LinBingKe/portable-soil-bulk-density-measuring-system/README.md

# portable-soil-bulk-density-measuring-system
Develop a portable soil bulk density measuring system for the fild measure immediately. The system composes of a 
soil bulk density sensor, a micro controller, and other components. The designed soil bulk density sensor collects 
the parameter with thermal theory. A micro controller combines with other components provides operation interface 
to collect, and upload data to cloud platform.
