LinBingKe/portable-soil-bulk-density-measuring-system/SystemHardware.pdf

# 可攜式總體密度量測系統

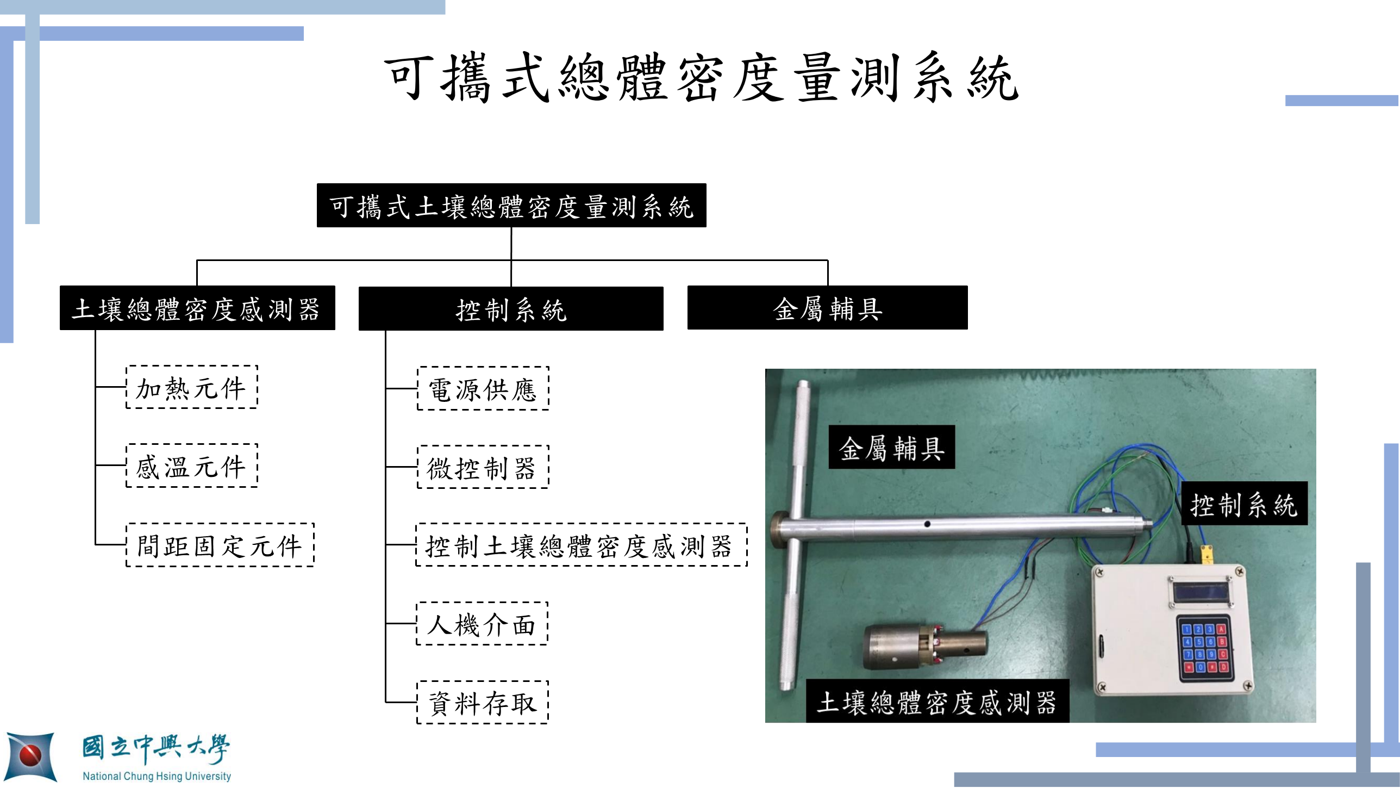
[picture p1: page 1]

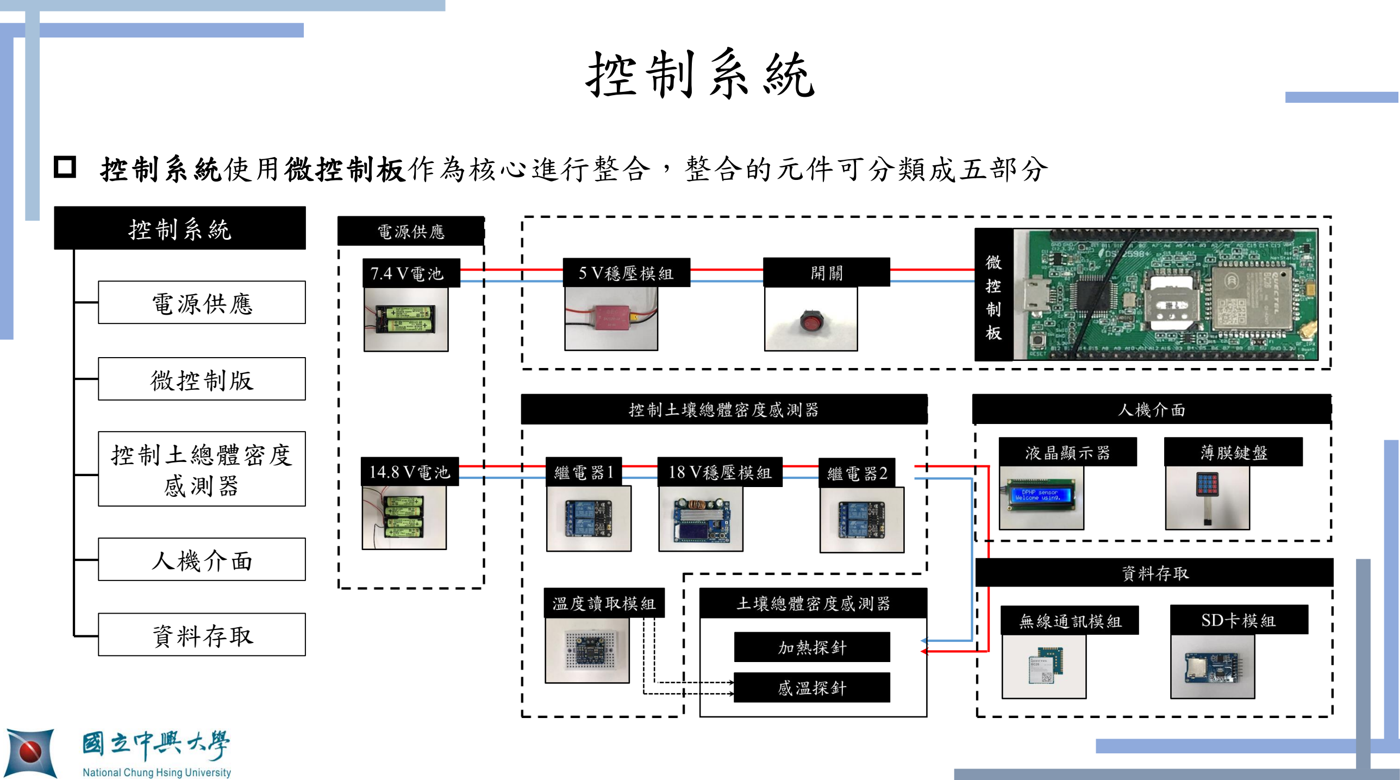
[picture p2: figure]
控制系統; 控制系統使用微控制板作為核心進行整合，整合的元件可分類成五部分; 電源供應; 微控制版; 控制土總體密度 感測器; 人機介面; 資料存取

# 硬體連接圖

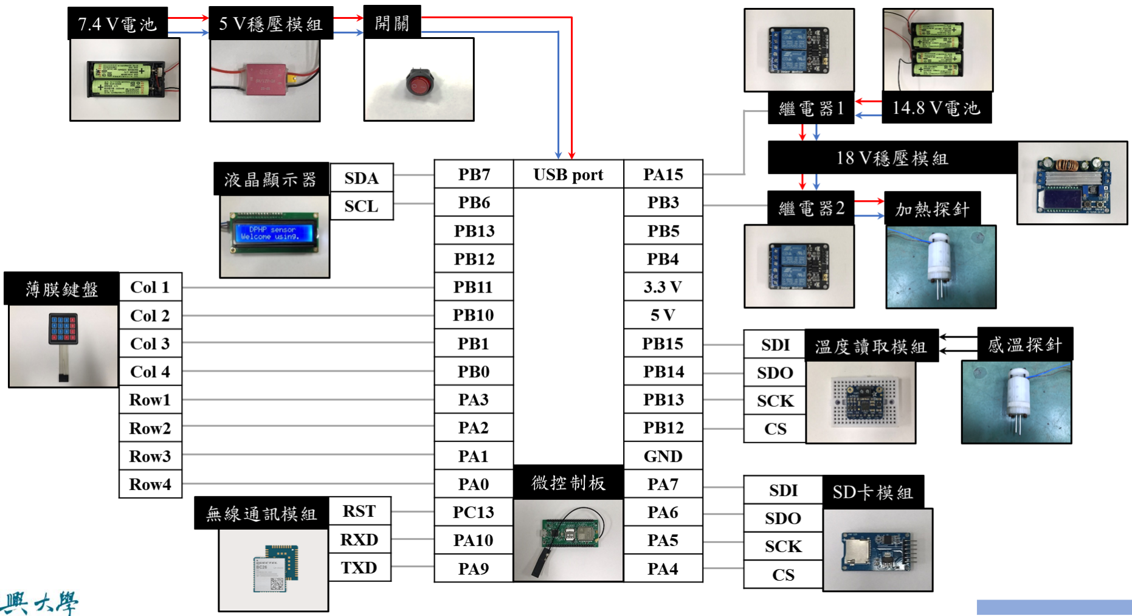
[picture p3: figure]

# 外部封裝殼

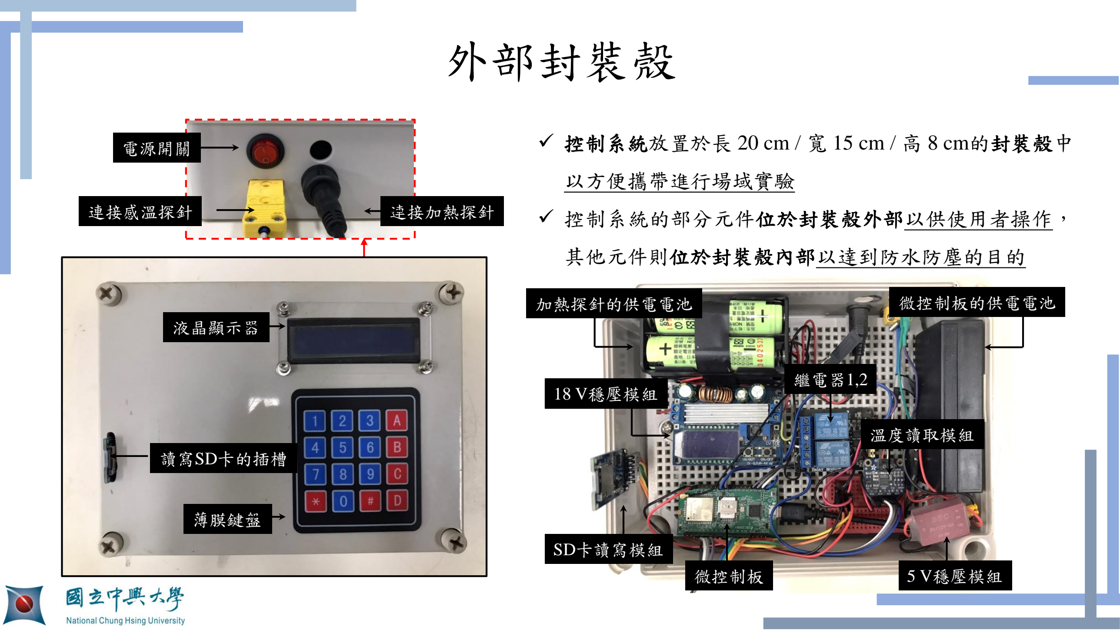
[picture p4: page 4]

加熱探針的供電電池 | 微控制板的供電電池
微控制板 | 5 V穩壓模組

18 V穩壓模組

✓ 控制系統放置於長 20 cm / 寬 15 cm / 高 8 cm的封裝殼中

以方便攜帶進行場域實驗

✓ 控制系統的部分元件位於封裝殼外部以供使用者操作，

其他元件則位於封裝殼內部以達到防水防塵的目的

連接感溫探針 | 連接加熱探針

電源開關

液晶顯示器

薄膜鍵盤

讀寫SD卡的插槽

SD卡讀寫模組

繼電器1,2

溫度讀取模組

場域操作量測系統 | 17

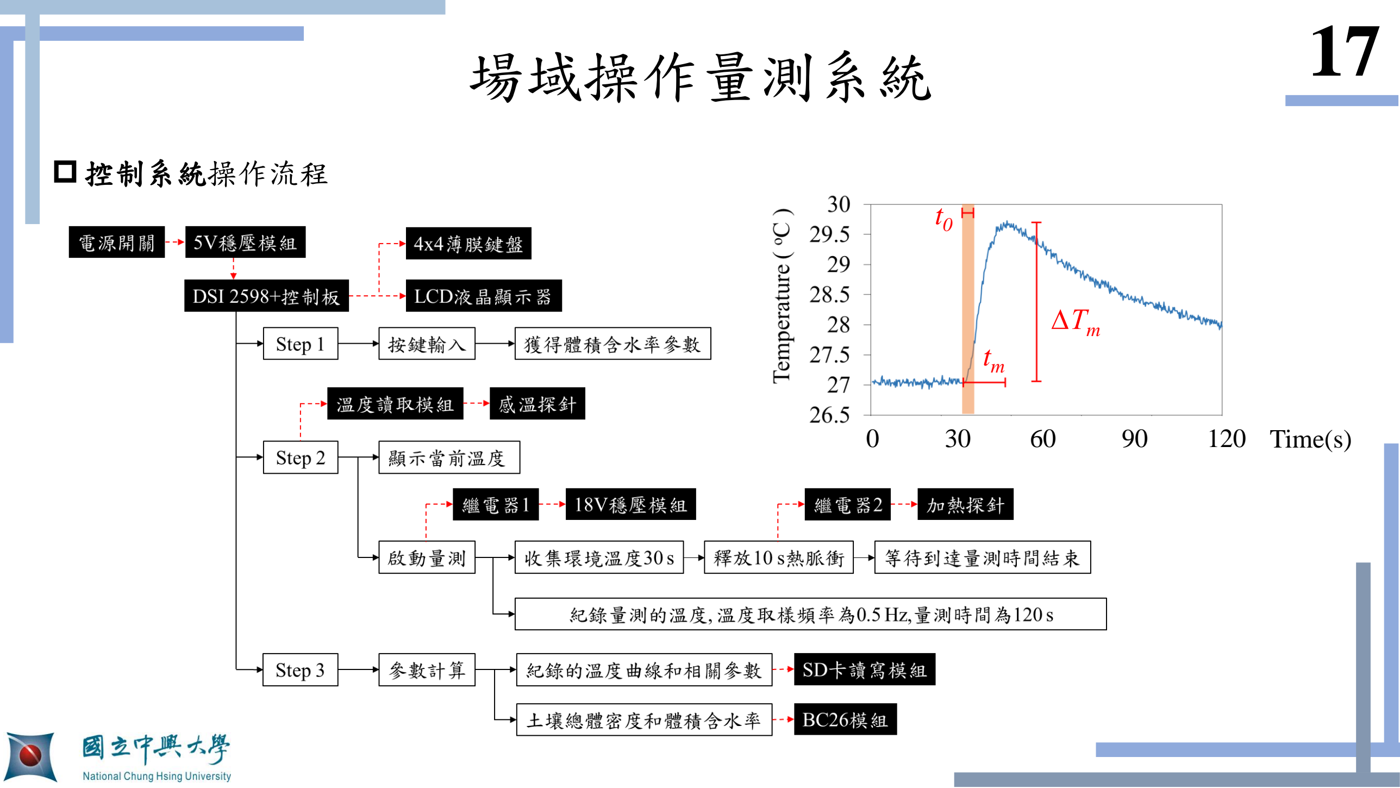
[picture p5: page 5]

- 控制系統操作流程

tm

∆Tm

t0

0 | 30 | 60 | 90 | 120 | Time(s)
