LinBingKe/portable-soil-bulk-density-measuring-system/中興生機系林秉科口試簡報.pdf

# 可攜式土壤總體密度量測系統

# 之研究與發展

# Research and development of portable soil bulk density

# measuring system

## 國立中興大學生物產業機電工程學系

## 指導教授: 蔡燿全 博士

## 研究生 : 林秉科

目錄

## - 研究動機和目的

## - 文獻回顧

## - 材料與方法-理論公式

## - 材料與方法-可攜式總體密度量測系統

## - 土壤總體密度感測器性能評估

## - 實驗室量測

## - 場域量測

- 結論

## - 研究動機

# 研究動機和目的

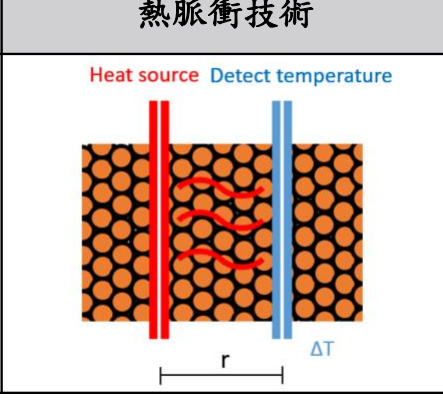
[picture p43: figure]
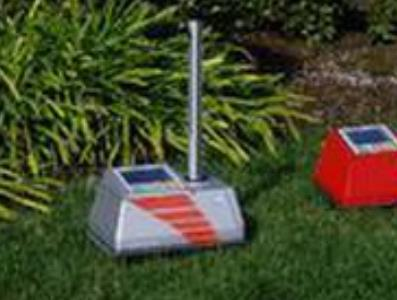
[picture p44: figure]

- 目的

### - 製作在場域可即時量測的土壤總體密度量測系統 - 未來應用:進一步探討土壤密度與作物關係

### - 智慧農業的興起:

### - 土壤總體密度的重要性 :影響土壤的透水性和可壓縮性 - 量測土壤總體密度的方式

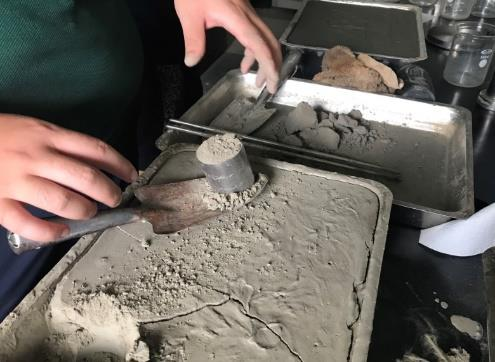
[picture p45: figure]
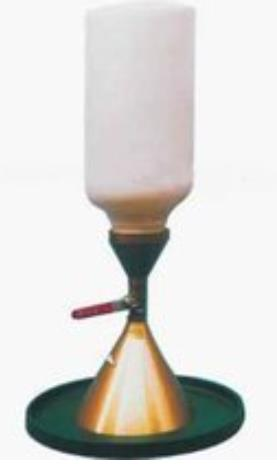
[picture p46: figure]

環刀法 | 開挖法
射線衰減技術 | 熱脈衝技術

1

溫溼度感測器 | 量測大氣的溫度和濕度
光量子感測器 | 量測太陽光
土壤水分張力計 | 量測土壤的含水率
酸鹼值感測器 | 量測土壤的酸鹼值
直接量測 | 環刀法、開挖法
間接量測 | 射線衰減技術、熱脈衝技術

# 文獻回顧-量測土壤熱性質

## Steady state heat flow method

1983
使用熱盤法量測粉末的導熱

係數，但之後有學者發現在

不飽和的土壤中進行量測，

長時間的加熱會導致水分在

土壤中重新分布造成量測誤

差

2

## Transient method

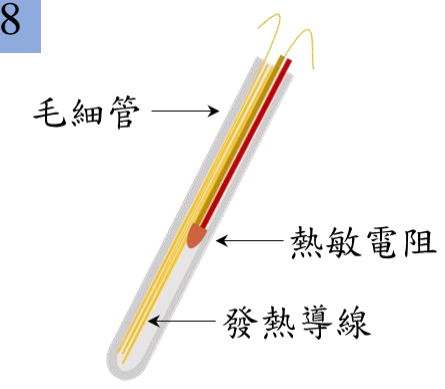
[picture p47: figure]

1990

開發出單探針形式量測
土壤熱性質的感測器雛
形，可以有效量測土壤
導熱係數，但是無法準
確量測土壤體積熱容量
和土壤熱擴散係數

開發出使用雙探針形式
量測土壤熱性質的感測
器雛形，可以量測土壤
導熱係數、體積熱容量
和熱擴散係數

1958

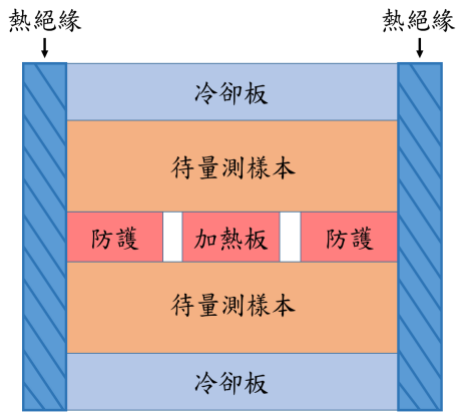
[picture p48: figure]
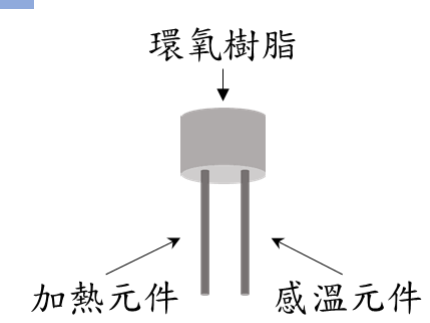
[picture p49: figure]

### - 土壤熱性質介紹

- 土壤體積熱容量(MJ m⁻³oC⁻¹

) : 描述每單位體積土壤所儲存的熱量

- 土壤導熱係數(W m⁻¹oC⁻¹

) : 描述土壤傳輸熱量的能力

- 土壤熱擴散係數(m²
s

-1

) : 描述溫度不均勻的土壤中溫度均勻化的速度

# 文獻回顧-熱脈衝感測器

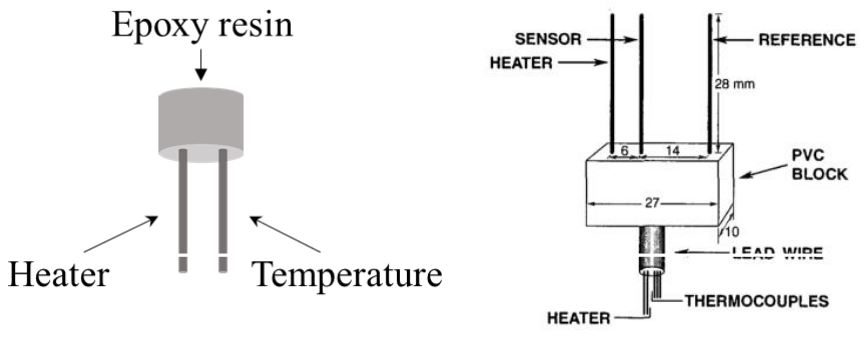
[picture p50: figure]
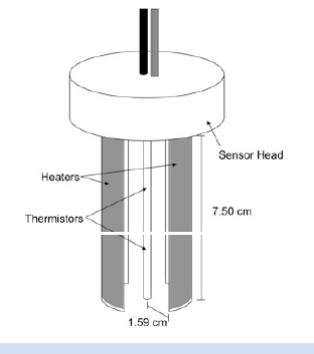
[picture p51: figure]
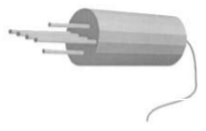
[picture p52: figure]

探針數量 | 2 | 3 | 6 | 1
探針直徑(mm) | 0.813 | 0.813 | 1.27 | 2.79
探針長度(mm) | 28 | 28 | 26 | 75
加熱導線電阻(Ω) | 38 | 31.9 | 21.3 | 8.1
加熱時間(s) | 1-8 | 8 | 8 | 8
間距(mm) | 6 | 6,20 | 6 | 15.9
Senrsor | 1991 | 1993 | 2003 | 2007

3

# 材料與方法-理論公式

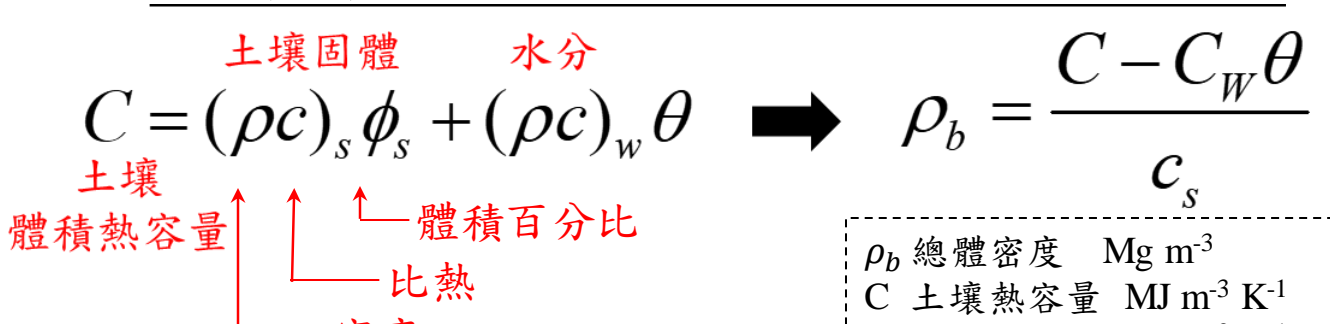
[picture p53: figure]
體積百分比; ρb 總體密度 Mg m⁻³ C 土壤熱容量 MJ m⁻³ K⁻¹
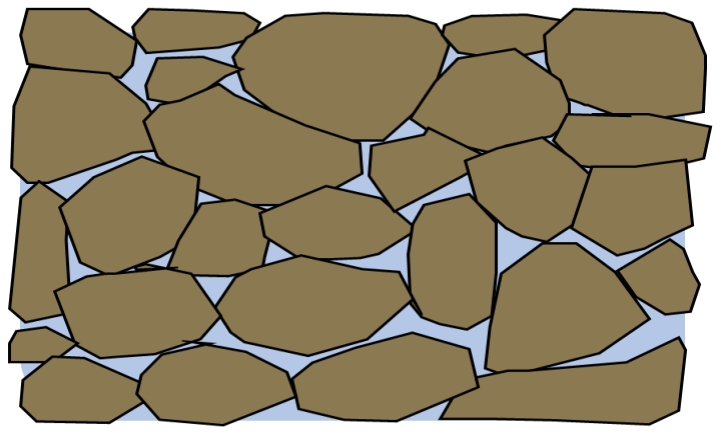
[picture p54: figure]

密度

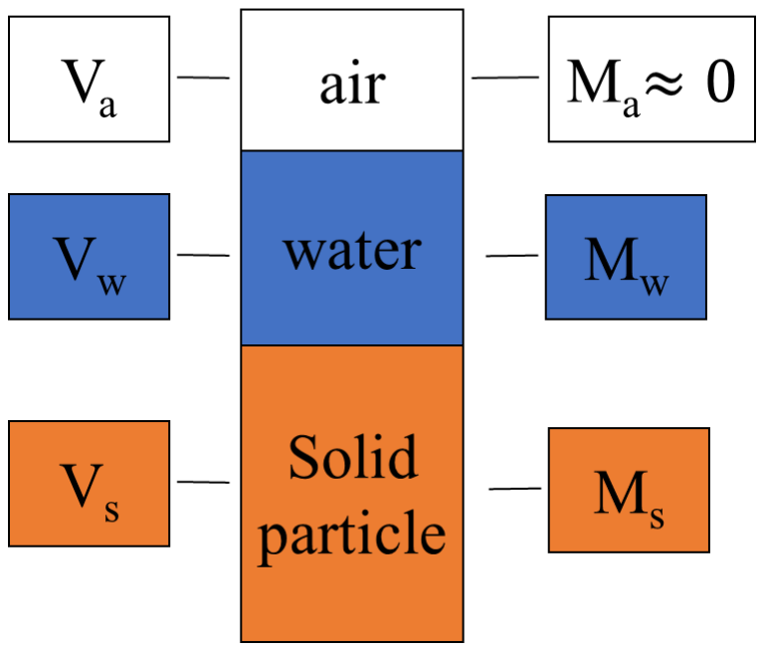
[picture p55: figure]

土壤成分 | 密度 Mg m⁻³ | 比熱 MJ Mg⁻¹ K⁻¹ | 導熱係數 W m⁻¹ K⁻¹ | 體積熱容量 MJ m⁻³ K⁻¹
石英 | 2.66 | 0.8 | 8.80 | 2.13
黏土礦物 | 2.65 | 0.9 | 2.92 | 2.39
有機物 | 1.30 | 1.92 | 0.25 | 2.50
水 | 1.00 | 4.18 | 0.57 | 4.18
空氣(20oC) | 0.0012 | 1.01 | 0.025 | 0.0012

## - 土壤組成成分

4

## - 土壤常見成份和體積熱容量

### ✓ 在得知土壤顆粒的比熱和體積含水率 的前提下，透過量測土壤體積熱容量 可以間接估算土壤總體密度

Cw水分熱容量 MJ m⁻³ K⁻¹
θ 含水率 %
cs 土壤固體比熱 MJ Mg⁻¹ K⁻¹

# 材料與方法-理論公式

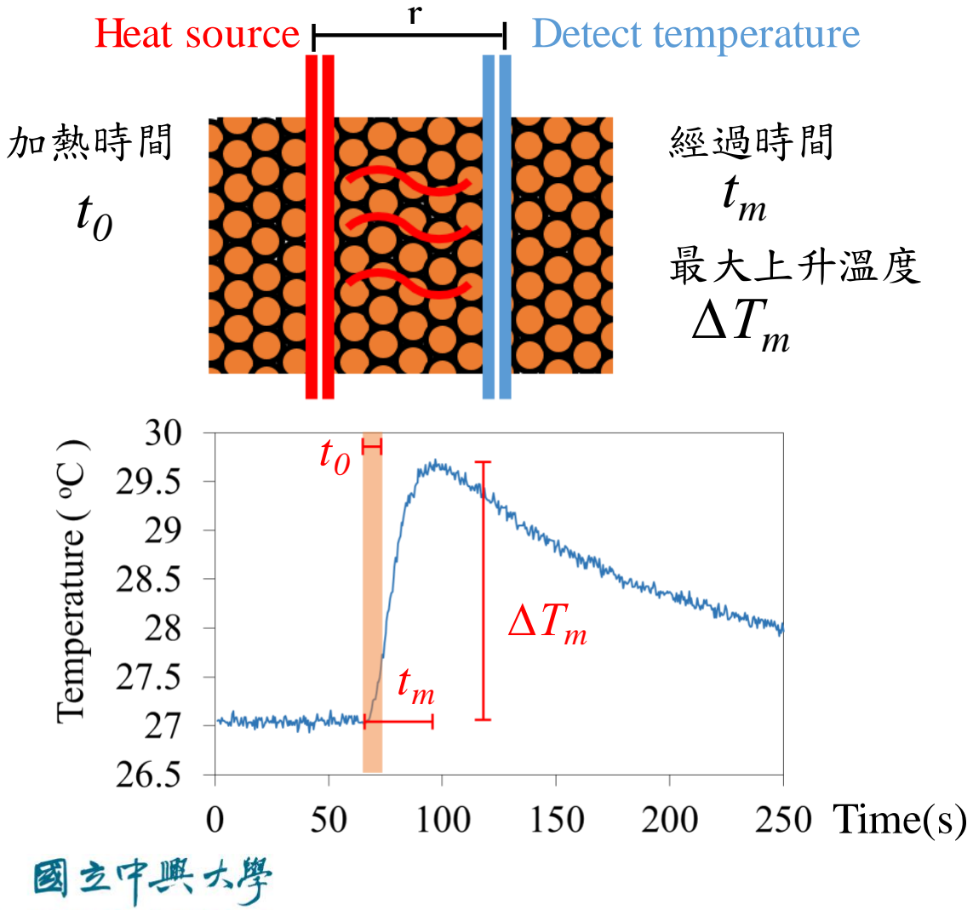
[picture p56: figure]
r Heat source; Detect temperature; 加熱時間; 經過時間; 最大上升溫度; Time(s)

α 熱損耗係數 | | 量測
q’ 功率 | (w m⁻¹
) | 給定
r 探針間距 | (m) | 給定
∆Tm 溫度變化 (K) | 量測
tm 最高溫度發生的時間點(s) 量測
t0 加熱的時間 (s) | 給定

## - 熱脈衝原理

5

2 | 2
1 | 1
0

'
[ ( | ) - ( | )]
4 | 4 | 4 ( | )
m | m | m
q | r | r C | E | E
T | t | t | t

α
πκ | κ | κ

=
Δ | −

2

0 | 0
1 | 1 [ | ]/ ln[ | ] 4 ( | )
m
m | m | m
r | t
t | t | t | t | t
κ = | −
− | −

## - 計算體積熱容量(C)和熱擴散係數(κ)

### ✓ 使用感測器收集最大上升溫度和經過時間可以計算 以上所需的參數

# 材料與方法-可攜式總體密度量測系統 6

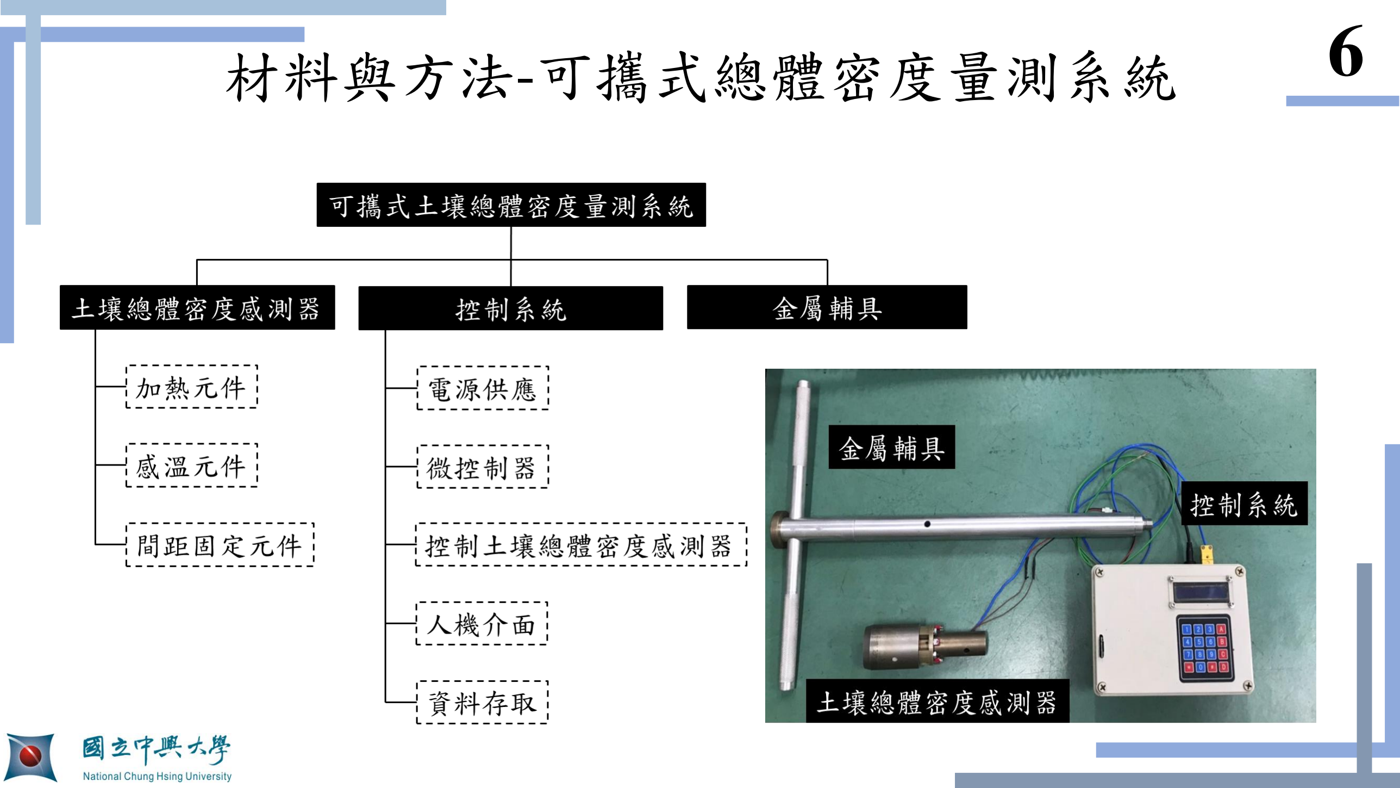
[picture p57: page 8]

# 材料與方法-可攜式總體密度量測系統

## - 土壤總體密度感測器 : 透過量測土壤熱性質間接量測土壤總體密度

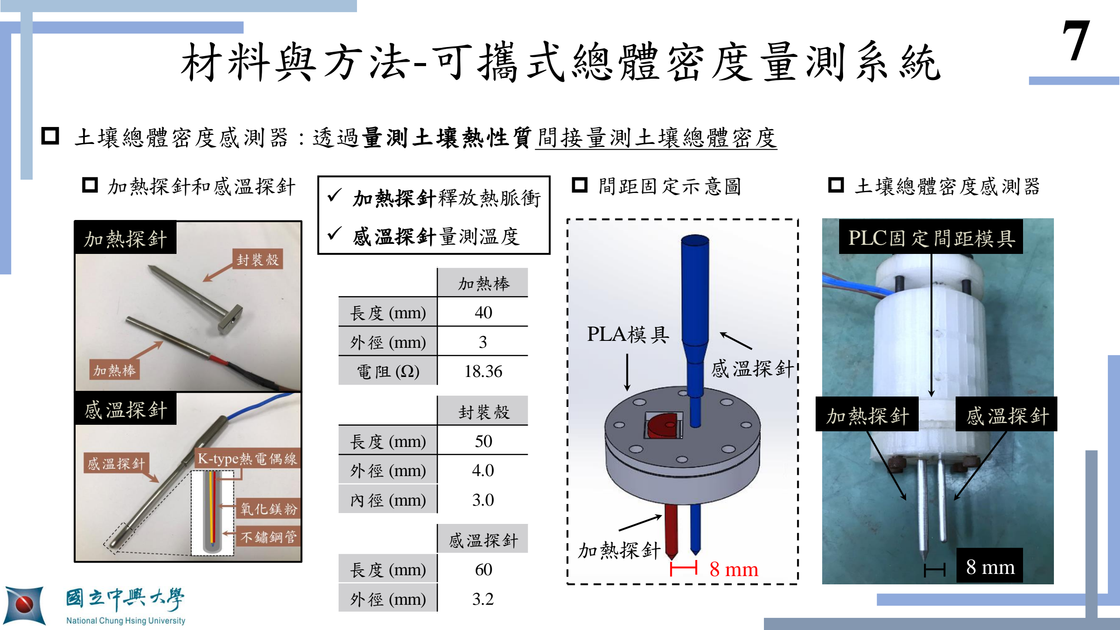
[picture p58: page 9]

7

8 mm

### 感溫探針

PLA模具

### 加熱探針

### 加熱探針 感溫探針

8 mm

### PLC固定間距模具

- 加熱探針和感溫探針 | 間距固定示意圖 | 土壤總體密度感測器
| 加熱棒
長度 (mm) | 40
外徑 (mm) | 3
電阻 (Ω) | 18.36
| 封裝殼
長度 (mm) | 50
外徑 (mm) | 4.0
內徑 (mm) | 3.0
| 感溫探針
長度 (mm) | 60
外徑 (mm) | 3.2

### 加熱探針

### 感溫探針

### ✓ 加熱探針釋放熱脈衝

### ✓ 感溫探針量測溫度

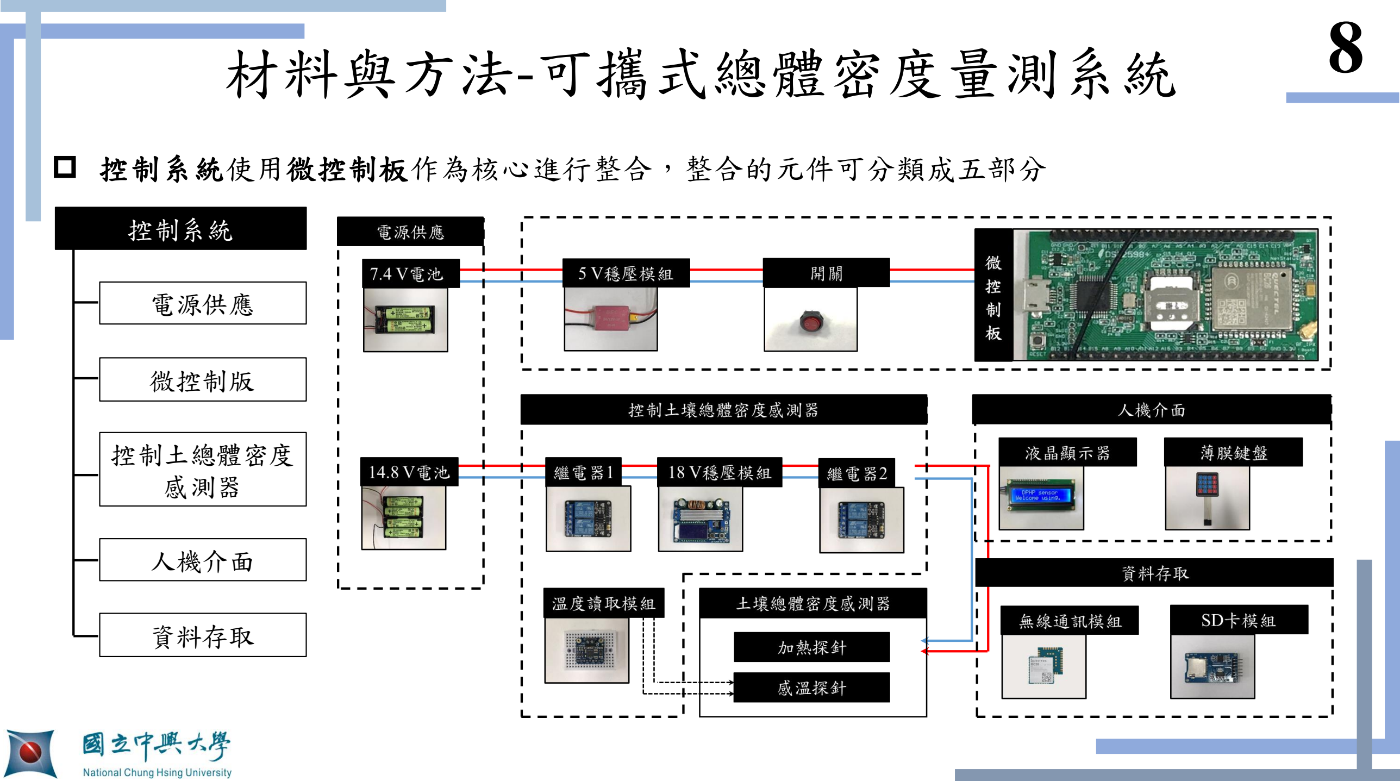
[picture p59: figure]
材料與方法-可攜式總體密度量測系統; 控制系統使用微控制板作為核心進行整合，整合的元件可分類成五部分; 電源供應; 微控制版; 控制土總體密度 感測器; 人機介面; 資料存取; 控制系統

# 材料與方法-可攜式總體密度量測系統

9

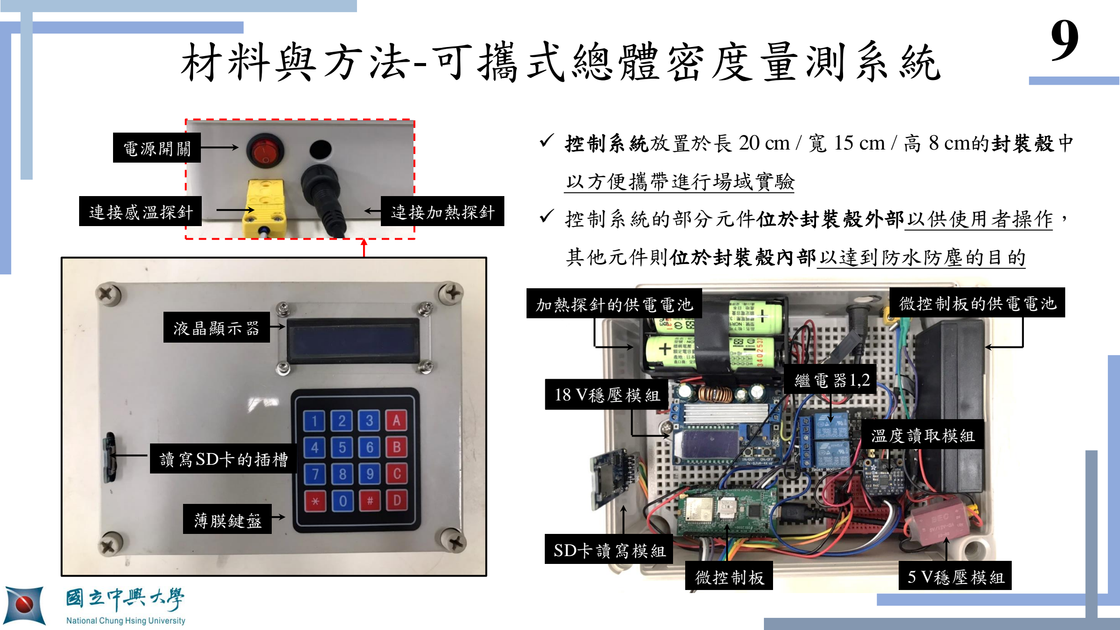
[picture p60: page 11]

加熱探針的供電電池 | 微控制板的供電電池
微控制板 | 5 V穩壓模組

18 V穩壓模組

### ✓ 控制系統放置於長 20 cm / 寬 15 cm / 高 8 cm的封裝殼中

### 以方便攜帶進行場域實驗

### ✓ 控制系統的部分元件位於封裝殼外部以供使用者操作，

### 其他元件則位於封裝殼內部以達到防水防塵的目的

連接感溫探針 | 連接加熱探針

電源開關

液晶顯示器

薄膜鍵盤

讀寫SD卡的插槽

SD卡讀寫模組

繼電器1,2

溫度讀取模組

# 材料與方法-可攜式總體密度感測系統

## - 量測用金屬輔具

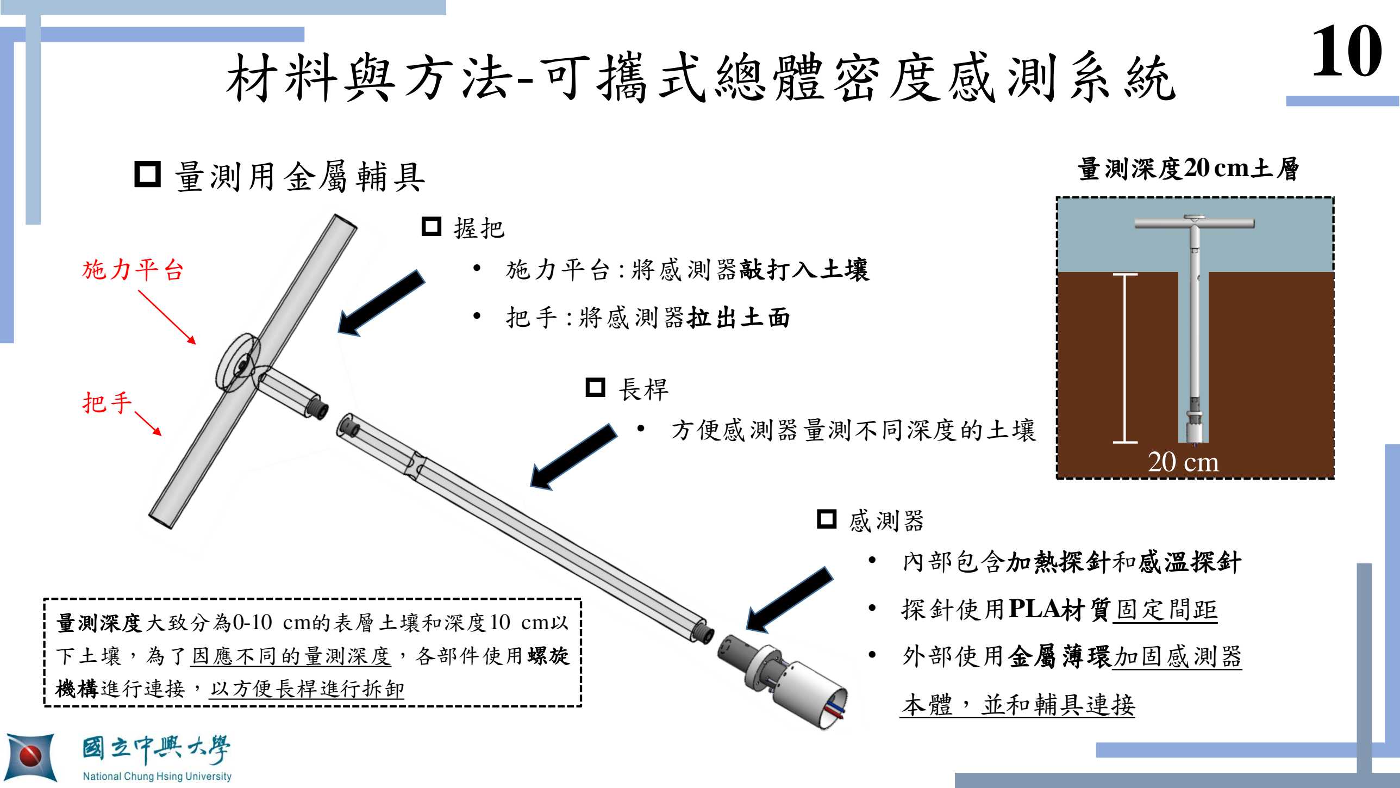
[picture p61: page 12]

- 握把

### - 施力平台 :將感測器敲打入土壤

### - 把手 :將感測器拉出土面

- 長桿

### - 方便感測器量測不同深度的土壤

### - 感測器 - 內部包含加熱探針和感溫探針

### - 探針使用PLA材質固定間距

### - 外部使用金屬薄環加固感測器

### 本體，並和輔具連接

### 施力平台

把手

### 量測深度20 cm土層

量測深度大致分為0-10 cm的表層土壤和深度10 cm以 下土壤，為了因應不同的量測深度，各部件使用螺旋
機構進行連接，以方便長桿進行拆卸

10

20 cm

土壤總體密度感測器性能評估 | 11

## - 評估加熱能力的設定參數

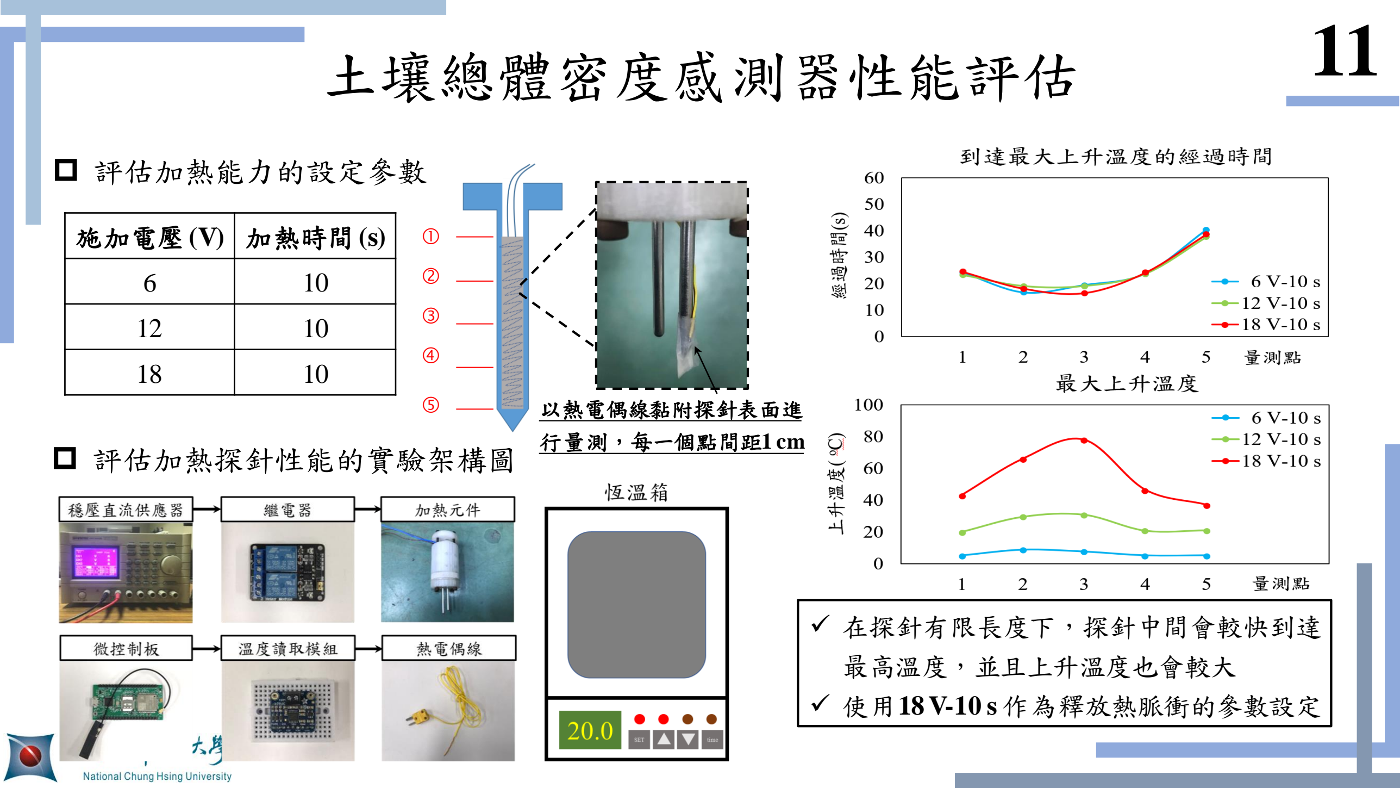
[picture p62: page 13]

施加電壓 (V) | 加熱時間 (s)
6 | 10
12 | 10
18 | 10

- 以熱電偶線黏附探針表面進
行量測，每一個點間距1 cm

### ✓ 在探針有限長度下，探針中間會較快到達 最高溫度，並且上升溫度也會較大 ✓ 使用18 V-10 s 作為釋放熱脈衝的參數設定

## - 評估加熱探針性能的實驗架構圖

# 土壤總體密度感測器性能評估

## - 加熱探針量測損耗係數 損耗係數為0.71

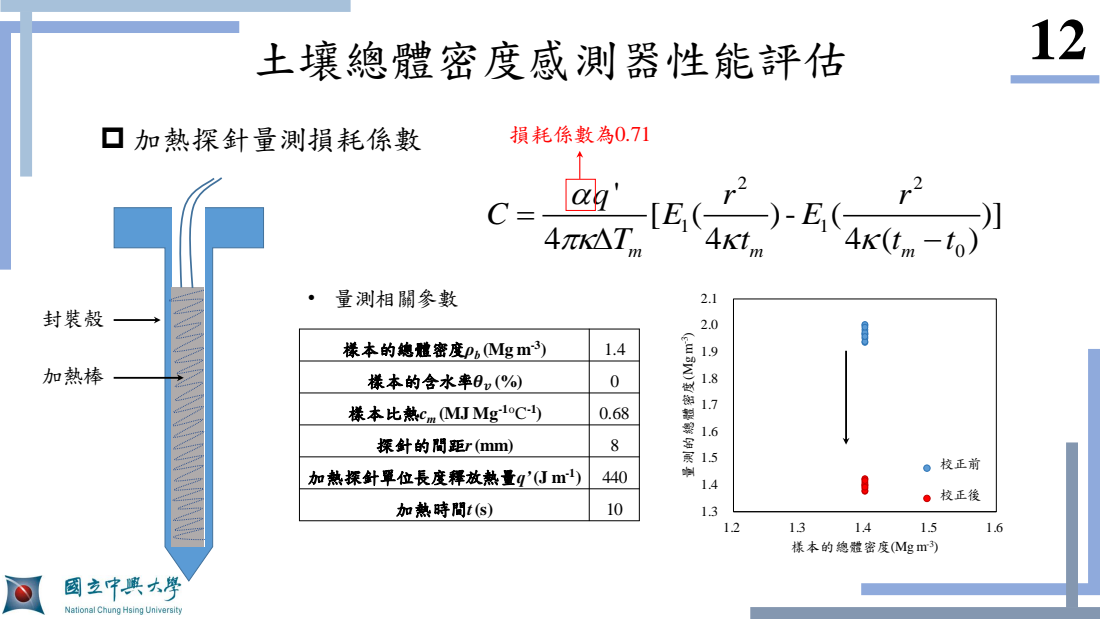
[picture p63: page 14]
封裝殼; 加熱棒; • 量測相關參數; 量測的總體密度(Mg m-3; 樣本的總體密度(Mg m⁻³ ); 校正前; 校正後

樣本的總體密度ρb (Mg m⁻³ ) | 1.4
樣本的含水率θv (%) | 0

樣本比熱cm (MJ Mg⁻¹oC⁻¹ ) | 0.68
探針的間距r(mm) | 8

加熱探針單位長度釋放熱量q’(J m⁻¹ ) | 440

加熱時間t(s) | 10

# 土壤總體密度感測器性能評估

## 感溫探針校正

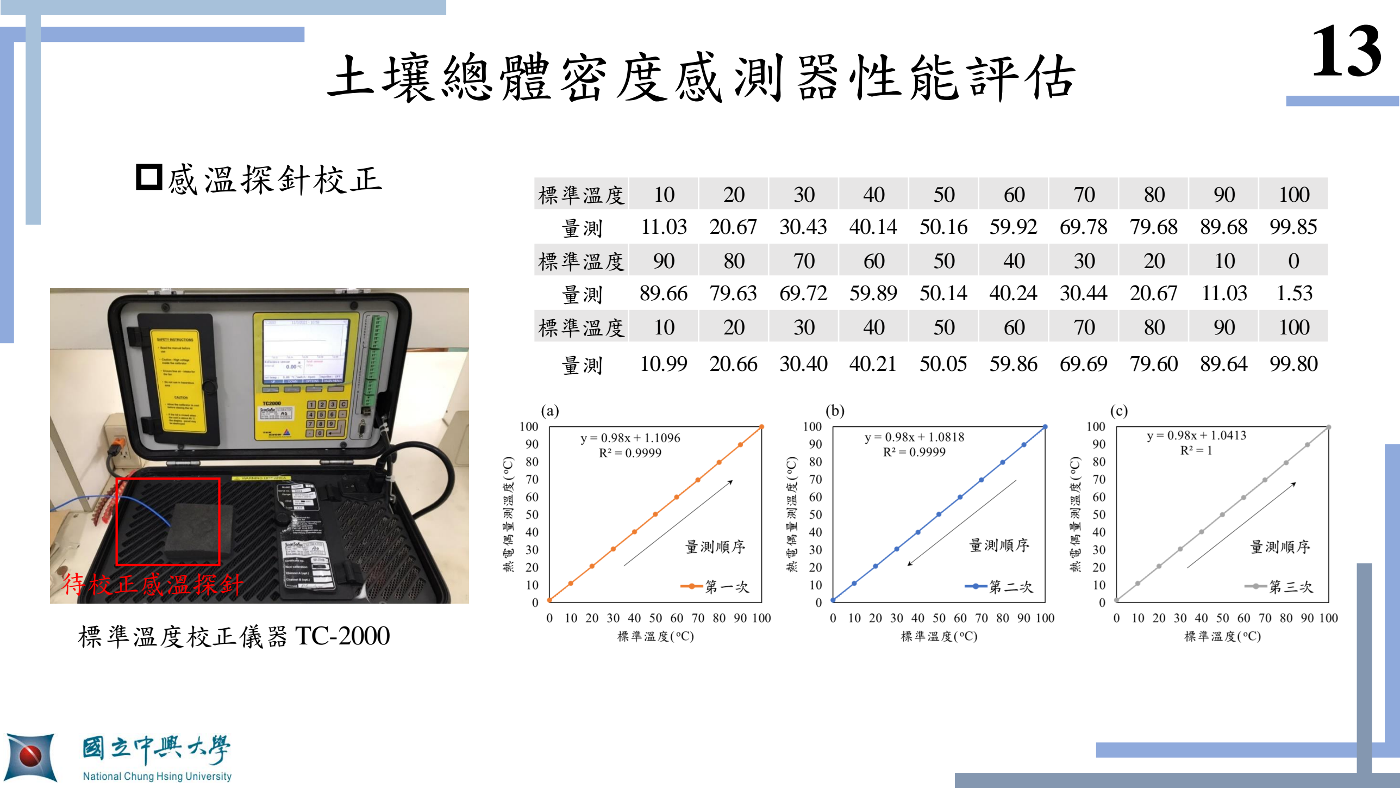
[picture p64: page 15]

### 待校正感溫探針

標準溫度 | 10 | 20 | 30 | 40 | 50 | 60 | 70 | 80 | 90 | 100
量測 | 11.03 | 20.67 | 30.43 | 40.14 | 50.16 | 59.92 | 69.78 | 79.68 | 89.68 | 99.85
標準溫度 | 90 | 80 | 70 | 60 | 50 | 40 | 30 | 20 | 10 | 0
量測 | 89.66 | 79.63 | 69.72 | 59.89 | 50.14 | 40.24 | 30.44 | 20.67 | 11.03 | 1.53
標準溫度 | 10 | 20 | 30 | 40 | 50 | 60 | 70 | 80 | 90 | 100
量測 | 10.99 | 20.66 | 30.40 | 40.21 | 50.05 | 59.86 | 69.69 | 79.60 | 89.64 | 99.80

13

### 標準溫度校正儀器 TC-2000

實驗室土壤製備 | 14

## - 目的 : 為了在實驗室的環境使用土壤總體密度感測器進行量測，需要製備標準土壤樣本

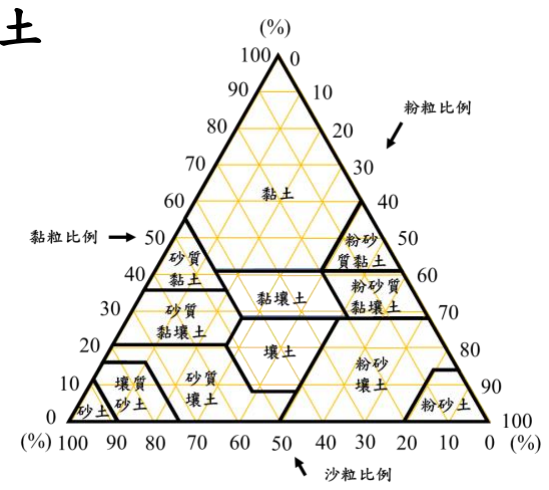
[picture p65: figure]
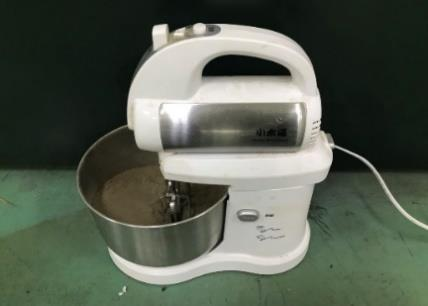
[picture p66: figure]

土壤總體密度g cm⁻³ | 1.2 | 1.4 | 1.6
土壤重量g | 120 | 140 | 160
土壤體積含水率% | 10 | 20 | 30
水分重量g | 10 | 20 | 30

### - 製作不同樣本所需要的土壤和水分重量

### - 土壤種類 : 壤土和砂質黏壤土

1.烘乾去除水分
(烤箱 105℃ and 24 hour)

2.製成粉末狀
(磨損試驗儀30 rpm 10 min)

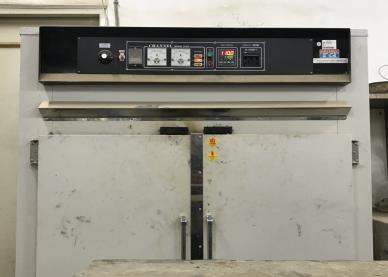
[picture p67: figure]

3.秤取特定重量的土壤和水分
使用攪拌器混合均勻

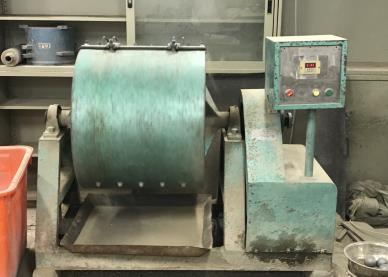
[picture p68: figure]

4.填充至容器內並將樣本壓實
(容器直徑5 cm、體積100 cm³
)

壓實輔具

夯槌

裝土容器

### - 製作標準土壤樣本的流程

土壤種類 | 壤土 | 砂質黏壤土
砂粒(%) | 42.62 | 55.14
粉粒(%) | 44.71 | 12.59
黏粒(%) | 15.41 | 29.45

實驗室量測結果 | 15

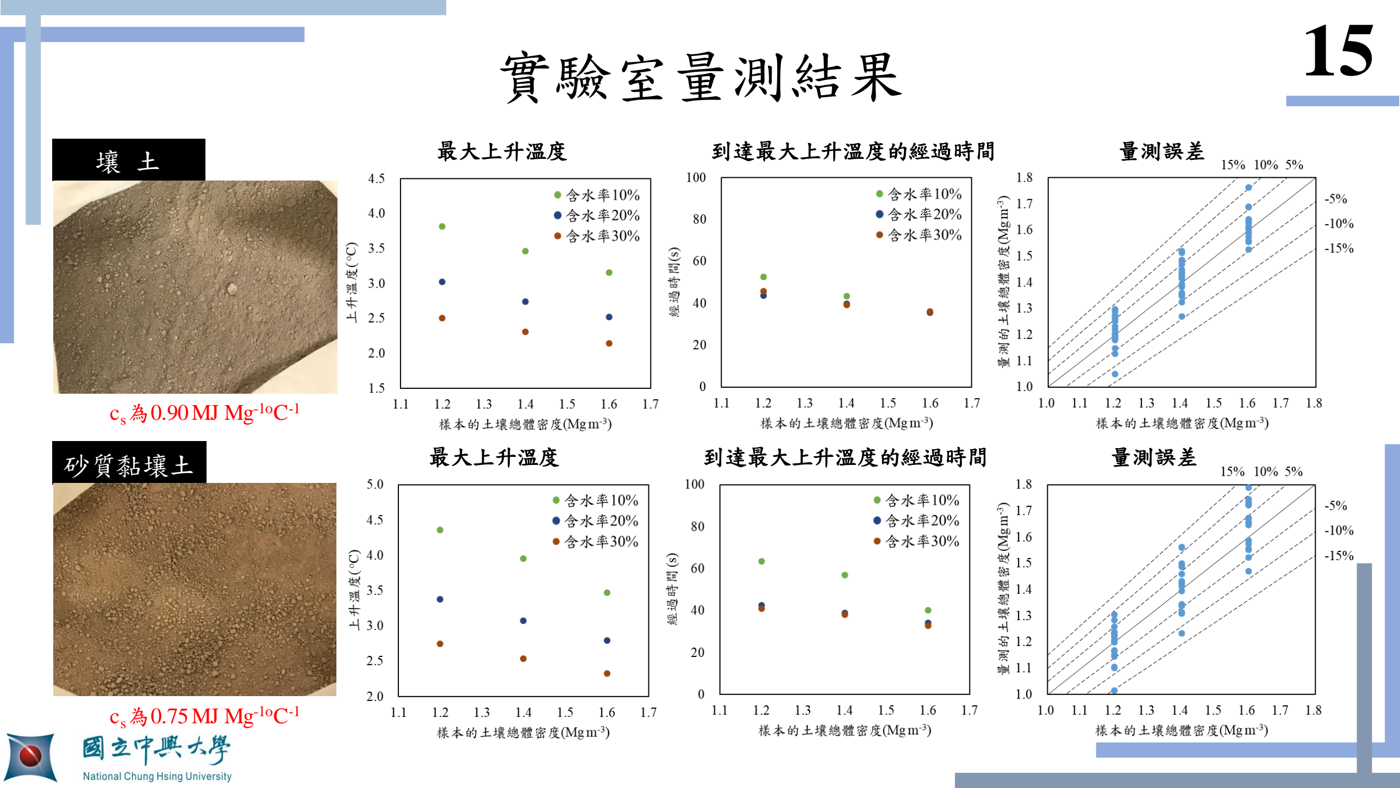
[picture p69: page 17]

壤
土
最大上升溫度 | 到達最大上升溫度的經過時間 | 量測誤差
最大上升溫度 | 到達最大上升溫度的經過時間 | 量測誤差
壤 | 土

### 砂質黏壤土

cs為0.90MJ Mg⁻¹oC⁻¹

cs為0.75MJ Mg⁻¹oC⁻¹

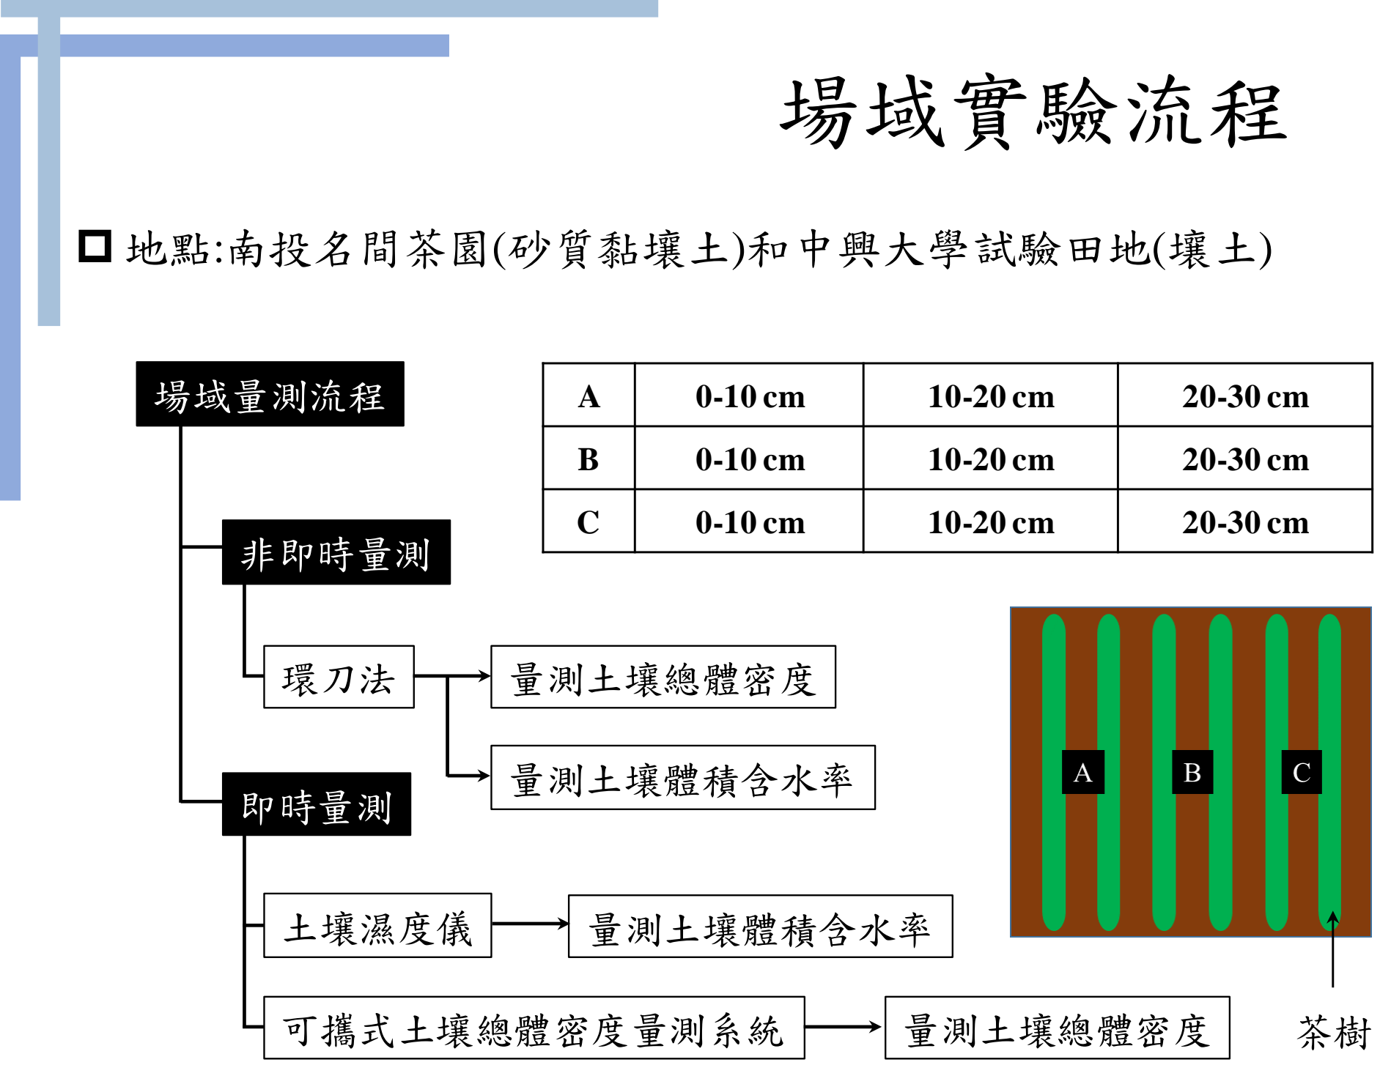
[picture p70: figure]
場域實驗流程; 地點:南投名間茶園(砂質黏壤土)和中興大學試驗田地(壤土); 土壤濕度儀; 可攜式土壤總體密度量測系統; 量測土壤體積含水率; 量測土壤總體密度; 場域量測流程; 即時量測; 非即時量測; 環刀法

16

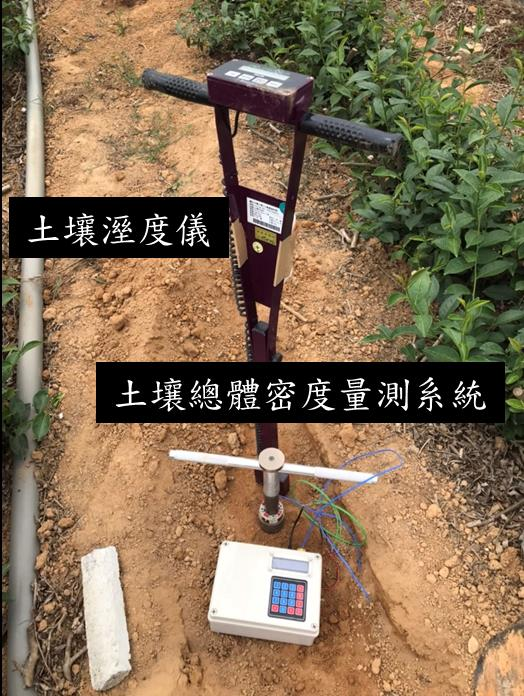
[picture p71: figure]

場域操作可攜式土壤總體密度量測系統 | 17

## - 控制系統操作流程

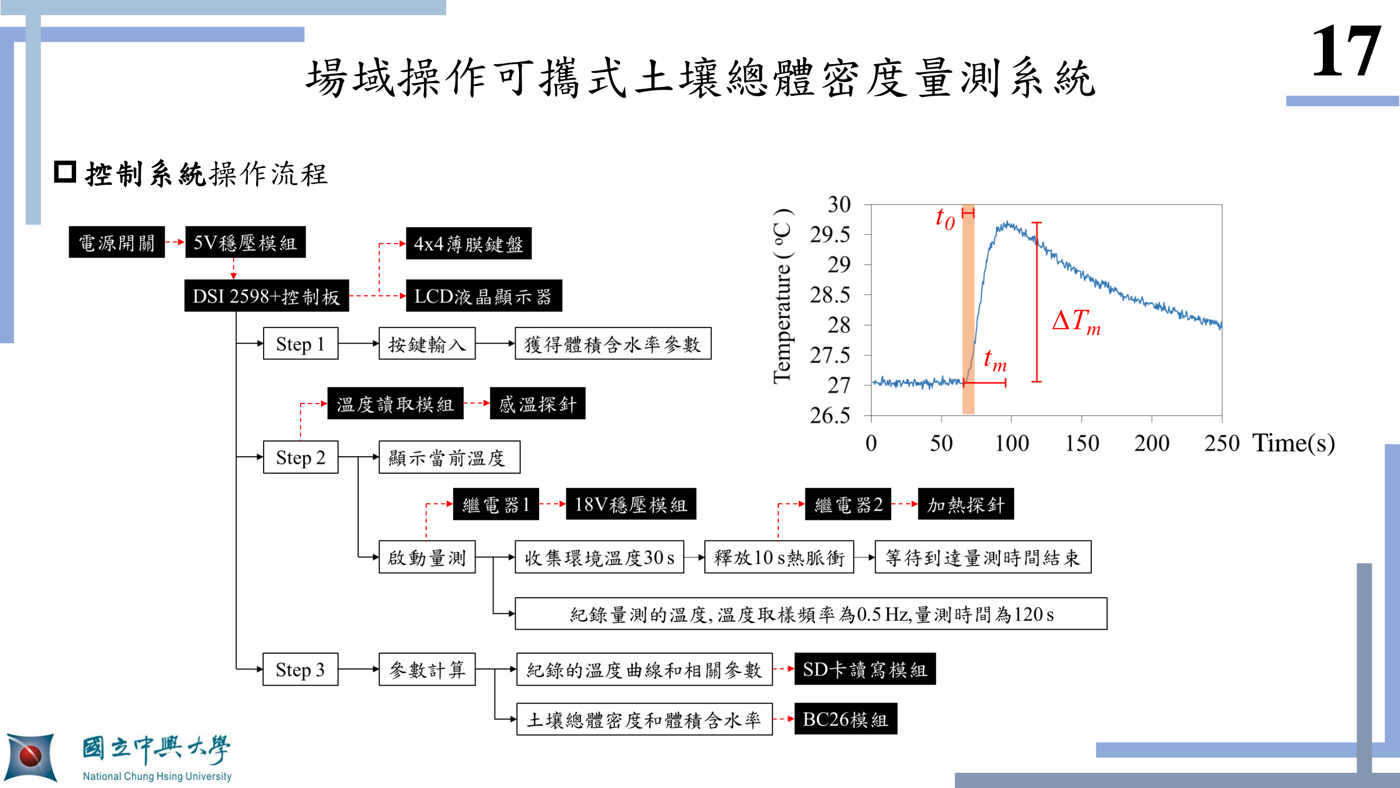
[picture p72: page 19]

tm

∆Tm

t0

Time(s)

中興大學試驗田地的量測結果 | 18

## - 使用環刀法量測不同深度的密度和含水率的分布情形

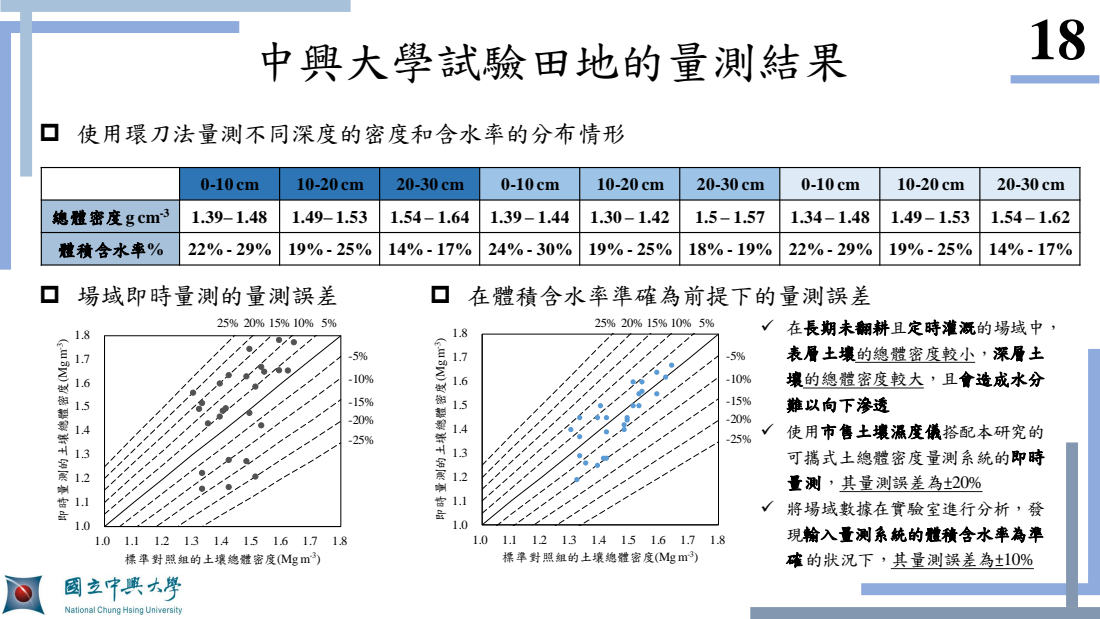
[picture p73: page 20]
場域即時量測的量測誤差; 在體積含水率準確為前提下的量測誤差; ✓ 在長期未翻耕且定時灌溉的場域中， 表層土壤的總體密度較小，深層土 壤的總體密度較大，且會造成水分 難以向下滲透; ✓ 使用市售土壤濕度儀搭配本研究的 可攜式土總體密度量測系統的即時 量測，其量測誤差為±20% ✓ 將場域數據在實驗室進行分析，發 現輸入量測系統的體積含水率為準 確的狀況下，其量測誤差為±10%; 即時量測的土壤總體密度(Mg m-3; 標準對照組的土壤總體密度(Mg m⁻³ )

總體密度g cm⁻³ | 1.39– 1.48 | 1.49– 1.53 | 1.54 – 1.64 | 1.39 – 1.44 | 1.30 – 1.42 | 1.5 – 1.57 | 1.34 – 1.48 | 1.49 – 1.53 | 1.54 – 1.62

體積含水率% | 22%- 29% | 19%- 25% | 14%- 17% | 24%- 30% | 19%- 25% | 18%- 19% | 22%- 29% | 19%- 25% | 14%- 17%

南投名間鄉茶園的量測結果 | 19

## - 使用環刀法量測不同深度的密度和含水率的分布情形

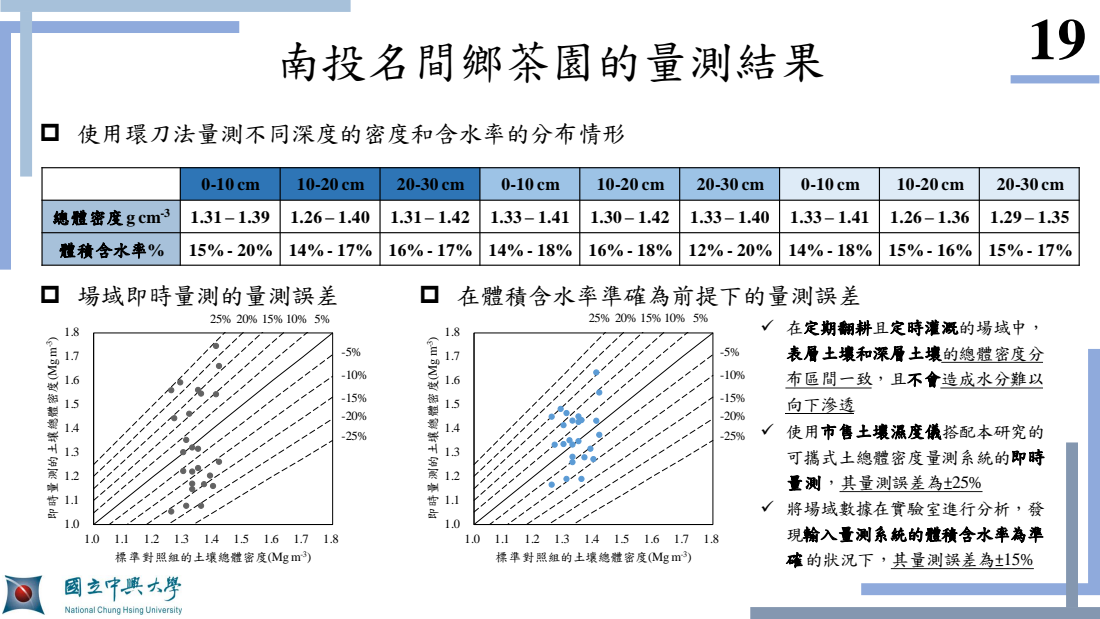
[picture p74: page 21]
場域即時量測的量測誤差; 在體積含水率準確為前提下的量測誤差; ✓ 在定期翻耕且定時灌溉的場域中， 表層土壤和深層土壤的總體密度分 布區間一致，且不會造成水分難以 向下滲透; ✓ 使用市售土壤濕度儀搭配本研究的 可攜式土總體密度量測系統的即時 量測，其量測誤差為±25% ✓ 將場域數據在實驗室進行分析，發 現輸入量測系統的體積含水率為準 確的狀況下，其量測誤差為±15%; 即時量測的土壤總體密度(Mg m-3; 標準對照組的土壤總體密度(Mg m⁻³ )

總體密度g cm⁻³ | 1.31 – 1.39 | 1.26 – 1.40 | 1.31 – 1.42 | 1.33 – 1.41 | 1.30 – 1.42 | 1.33 – 1.40 | 1.33 – 1.41 | 1.26 – 1.36 | 1.29 – 1.35

體積含水率% | 15%- 20% | 14%- 17% | 16%- 17% | 14%- 18% | 16%- 18% | 12%- 20% | 14%- 18% | 15%- 16% | 15%- 17%

結論 | 20

### - 成功開發一套可攜式的土壤總體密度量測系統

### - 在實驗室中使用量測系統的土壤總體密度感測器進行量測，量測結果顯示土壤總體密

### 度和最大上升溫度為線性關係

### - 在場域中可攜式土壤總體密度量測系統具有操作方便和量測快速的優點，相較於傳統

### 方式需要將土壤樣本帶回實驗室處理具有極大的優勢

### - 本研究開發的可攜式土壤總體密度量測系統搭配市售土壤濕度儀進行即時量測，在南

### 投名間鄉茶園和中興大學試驗田地進行場域實驗，其量測誤差分別為±25%和±20%

### - 根據場域實驗完的數據分析顯示場域即時量測的部分誤差來自於使用市售土壤濕度儀

### 量測體積含水率的不準確。在體積含水率為準確的前提下，可以有效降低場域即時量

### 測的誤差，分別從±25%到±15%和從±20%到±10%

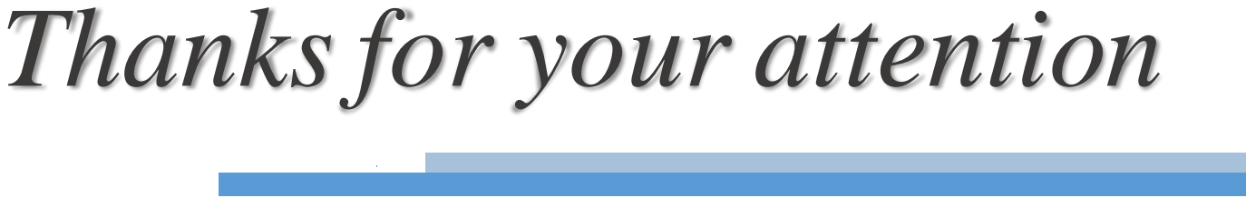
[picture p75: figure]
Thanks for your attention
