LinBingKe/portable-soil-bulk-density-measuring-system/MeasureSystemTest/BC26Init.h

#include <ArduinoJson.h>

byte Rset_Count=0;            //  系統重新啟動計時器宣告
int waitingTime = 30000;      // 等候 30 秒的回覆.

String Check_RevData()  // 讀取收到的每一字元資料 ，彙整成一個字串
{
 String data= "";	
 char c;
 while (Serial1.available())
 {
  delay(50);
  c = Serial1.read(); //Conduct a serial read
  data+=c; //Shorthand for data = data + c
  if (c=='\n') break;
 }
 data.trim();
 return data;  
}

byte Send_ATcommand(String msg,byte stepnum) // 傳送 AT command ，並加以判斷
{
 String Showmsg,C_temp;
 Serial.println(msg);
 Serial1.println(msg);
 Showmsg=Check_RevData();
 //Serial.println(Showmsg);
 long StartTime=millis();
 switch (stepnum)
  {
    case 0:  // Reset BC26
         C_temp="+IP:";
         break;    
    case 1:         // Other Data
         C_temp="OK";
         break; 
    case 2:         // Check IPAddress 
         C_temp="+CGPADDR:"; 
         break; 
    case 10:  // build MQTT Server
         C_temp="+QMTOPEN: 0,0";
         break;        
    case 11: // Connect to MQTT server by username and password
         C_temp="+QMTCONN: 0,0,0";
         break;  
    case 12: // Publisher MQTT Data 
         C_temp="+QMTPUB: 0,0,0";
         break;        
    case 13: // Sub MQTT Data 
         C_temp="+QMTSUB: 0,1,0,0";
         break;
  }
  while (!Showmsg.startsWith(C_temp))
  {
   Showmsg=Check_RevData();
   if (Showmsg.startsWith("+")) Serial.println(Showmsg);
   if ((StartTime+waitingTime) < millis()) return stepnum;
  }          
  return 99;
}

bool BC26init()  // 初始化 BC26
{
 Send_ATcommand("AT+QGACT=1,1,\"apn\",\"internet.iot\"",1);
 Send_ATcommand("AT+QCGDEFCONT=\"IP\",\"internet.iot\"",1);
 Send_ATcommand("AT+QBAND=1,8",1); 
 Send_ATcommand("AT+QRST=1",0);
 if (Send_ATcommand("ATE0",1)==99)
  if (Send_ATcommand("AT+CGPADDR=1",2)==99) return true;
 return false;   

}

bool connect_MQTT(String Serverx,String port,String user,String pass) // 建立 MQTT 連線通道
{
 String S_temp;
 S_temp = "\"" + Serverx + "\"" + "," + port;
 S_temp="AT+QMTOPEN=0," + S_temp;
 //Serial.println(S_temp);
 if (Send_ATcommand(S_temp,10)!=99) return false;
 //delay(100);
 S_temp= "\"" + user + "\"" + "," + "\"" + pass + "\"";
 S_temp="AT+QMTCONN=0,0," + S_temp;
 //Serial.println(S_temp);
 if (Send_ATcommand(S_temp,11)!=99) return false;
 //delay(100);
 return true;
}

bool Publish_MQTT(String topic, String message) // 發佈資料
{ 
 String S_temp;
 S_temp = "\"" + topic + "\"" + "," + message ;
 S_temp = "AT+QMTPUB=0,0,0,0," + S_temp ;
 //Serial.println(S_temp);
 if (Send_ATcommand(S_temp,12)!=99) return false; 
 //delay(100);
 return true;
}

bool Sub_MQTT(String topic) // 訂閱資料
{
 String S_temp;
 S_temp = "\"" + topic + "\"" + "," + "0";
 S_temp = "AT+QMTSUB=0,1," + S_temp; 
 //Serial.println(S_temp);
 if (Send_ATcommand(S_temp,13)!= 99) return false;  
 //delay(100); 
 return true; 
}

bool Close_MQTT() // 關閉連線
{ 
 String S_temp;
 S_temp="AT+QMTCLOSE=0";
 if (Send_ATcommand(S_temp,1)!=99) return false; 
 //delay(100);
 return true;
}


String JSON_DEC_data (String input,String findData)
{
 int index = input.indexOf(',');
 int x = input.substring(0, index).toInt();
 String json = input.substring(index + 1, input.length());
 //Serial.println(json);
 index = json.indexOf(':');
 x = json.substring(0, index).toInt();
 json = json.substring(index + 1, json.length());
 //Serial.println(json);
 DynamicJsonDocument doc(1024);
 deserializeJson(doc, json);
 JsonObject obj = doc.as<JsonObject>();
 return obj[findData];
}

bool Sub_Ideaschain(String attrestopic)
{
 String S_temp;
 S_temp="\""+ attrestopic + "\"" + "," + "0";
 S_temp="AT+QMTSUB=0,1," + S_temp;  // Qos 0 
 Serial.println(S_temp);
 Serial1.println(S_temp);
 delay (2000);
 return true; 
}

String Get_Publish_MQTT(byte mode,String attreqtopic , String message) // 取得 Ideaschain 屬性資料
{
 String Showmsg; 
 String S_temp,T_temp;
 //delay (1000);
 if (mode==0) T_temp="sharedKeys";
 if (mode==1) T_temp="clientKeys";
 S_temp="\"" + attreqtopic + "\"" + "," + "\"{\"" + T_temp + "\":\"" + message + "\"}\"";
 S_temp="AT+QMTPUB=0,0,0,0," + S_temp; 
 Serial.println(S_temp);
 Serial1.println(S_temp);
 Showmsg=Check_RevData();
 long StartTime=millis();
 while (!Showmsg.startsWith("+QMTRECV:"))
 {
  delay(100);
  Showmsg=Check_RevData();  
  if (Showmsg.length()>30) break;
  //Serial.println(Showmsg);
  if ((StartTime+waitingTime) < millis()) return "error";
 }
 //Serial.println(Showmsg);         
 return JSON_DEC_data (Showmsg,message);
}
